lgitrt/DroneController/Assembly2.stl

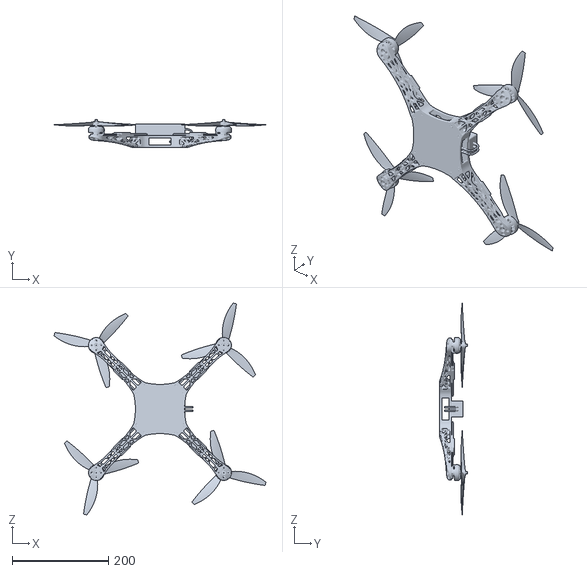
[picture p11: CAD file, 2026-10-02, last stored version]
Assembly2.stl
439.6 x 58.8 x 439.6
