lgitrt/DroneController/vector.stl

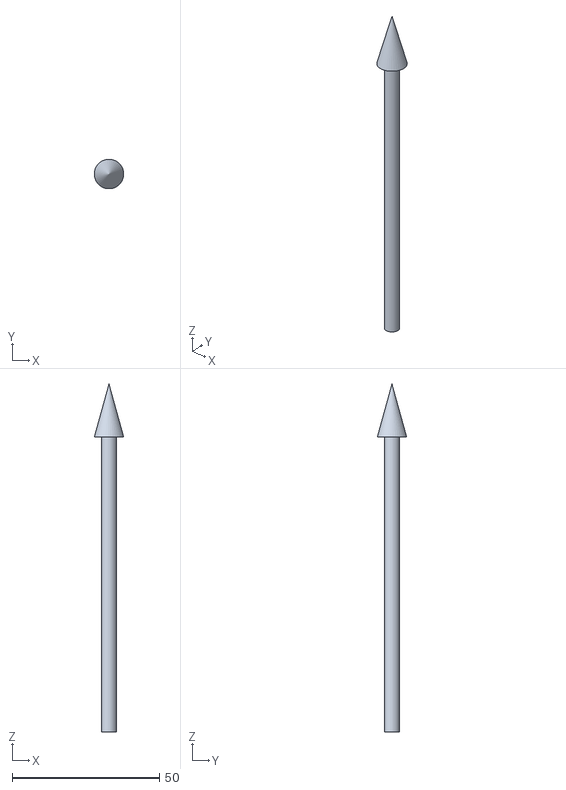
[picture p12: CAD file, 2026-10-02, last stored version]
vector.stl
9.99 x 9.98 x 118.0
