lgitrt/DroneController/simulation/results/metrics.csv

rmse3D | rmseCoordinate | rmsePerAxis_1 | rmsePerAxis_2 | rmsePerAxis_3 | rmseCircle3D | maxError3D | meanCommandDeviation | peakCommandStep | saturatedSamples | rateLimitedSamples | meanSolveTimeMs | maxSolveTimeMs | estimationPositionRMSE | estimationAttitudeRMSEDeg | scenario | controller
0.0178046399109007 | 0.0102795136453829 | 0.000950504631318332 | 0.000624533601822021 | 0.0177682779436522 | 0.00467186624388359 | 0.0752451704655104 | 4602.85762935558 | 0.0106209011376921 | 0 | 0 | 0.00267288888888889 | 0.0509 | 0 | 0 | Ideal baseline | LQR
0.00271685040925663 | 0.00156857431513226 | 0.000808077234212324 | 0.000516532399092589 | 0.00254194445464753 | 0.000884098852815674 | 0.0129169398279457 | 3961.38499079515 | 0.0259945474537169 | 0 | 0 | 12.9785901111111 | 19.1804 | 0 | 0 | Ideal baseline | MPC
0.00389352958771861 | 0.00224793035556711 | 0.00298809711484834 | 0.00222293713088047 | 0.00113551697249677 | 0.00163082225779905 | 0.0172624434986543 | 4034.92906290898 | 0.0123291770886608 | 0 | 0 | 0.0307911111111111 | 2.373 | 0 | 0 | Ideal baseline | PID
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
