lgitrt/DroneController/simulation/results/validation.csv

seed | scenario | controller | rmse3D | rmseCircle3D | rmseWindWindow | rmseRecovery | maxError3D | estimationPositionRMSE | estimationAttitudeRMSEDeg | maxTiltDeg | saturatedSamples | rateLimitedSamples
20261002 | Noisy sensors and EKF | LQR | 0.0330699491699417 | 0.0227247132153702 | 0.0244519361269129 | 0.02149828647545 | 0.117047857946727 | 0.0179100170010101 | 0.379422865232148 | 4.27293983269353 | 0 | 0
20261002 | Noisy sensors and EKF | MPC | 0.0244736984666733 | 0.0225876530354913 | 0.024825329715124 | 0.0214561852056178 | 0.04795182974722 | 0.0179049760461515 | 0.443083907621406 | 4.26426362282017 | 0 | 0
20261002 | Noisy sensors and EKF | PID | 0.0307494063689642 | 0.0283685834344498 | 0.0283064235455322 | 0.0232350668166645 | 0.0577169099464077 | 0.0179078414650569 | 0.40836027133457 | 3.65467926419492 | 0 | 0
20261002 | Wind, motor lag and sensors | LQR | 0.056268005718662 | 0.053235268309342 | 0.0795856451433738 | 0.0222374167342717 | 0.130447094556258 | 0.0178557113670422 | 0.323838967380567 | 4.58011159055663 | 0 | 0
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
