lgitrt/DroneController/Core/Src/main.c

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
/* Includes ------------------------------------------------------------------*/
#include "main.h"

/* USER CODE BEGIN Includes */
#include <stdio.h>
#include "IMU_KF.h"
#include "PID.h"
#include "mpu6050.h"

/* USER CODE END Includes */

I2C_HandleTypeDef hi2c1;

TIM_HandleTypeDef htim1;
TIM_HandleTypeDef htim2;
TIM_HandleTypeDef htim3;
TIM_HandleTypeDef htim4;
TIM_HandleTypeDef htim6;
TIM_HandleTypeDef htim8;
TIM_HandleTypeDef htim15;
TIM_HandleTypeDef htim16;
TIM_HandleTypeDef htim17;

/* USER CODE BEGIN PV */
struct est estimate;
struct est estimateCompFilter;
struct motSpeeds omegaMot;
struct motSpeeds motorPWM;
long unsigned t_main = 0;
double ts = 0.001; 	// ts in s
double phiEst = 0;
double thetaEst = 0;
double yawInt = 0;
float recRoll; float recPitch; float recYaw; float recAltitude;
float rollMin = -pi/4; float rollMax = pi/4;
float pitchMin = -pi/4; float pitchMax = pi/4;
float thrustMin = 0; float thrustMax = 80; // [N]
uint32_t recRollDuty; uint32_t recPitchDuty; uint32_t recYawDuty; uint32_t recThrustDuty;		//tim15 = pitch, tim8 = roll, tim16 = yaw, tim17 = thrust
uint32_t recRollCapt; uint32_t recPitchCapt; uint32_t recYawCapt; uint32_t recThrustCapt;
uint16_t timeTaken = 0;
uint32_t recRollDutyZero = 750; uint16_t recRollDutyMax = 209;  uint16_t recRollDutyMin = -209;
uint32_t recPitchDutyZero = 205; uint16_t recPitchDutyMax = 57; uint16_t recPitchDutyMin = -57;
uint32_t recYawDutyZero = 195; uint16_t recYawDutyMax = -56; uint16_t recYawDutyMin = 56;
uint32_t recThrustDutyZero = 147; int16_t recThrustDutyMax = 113; int16_t recThrustDutyMin = 0;
uint16_t phiPlot = 0;

float alphaAlt = 0.001; float recAltitudeOld = 0;
float alphaRoll = 0.01; float recRollOld = 0;
float alphaPitch = 0.01; float recPitchOld = 0;
float alphaYaw = 0.005; float recYawOld = 0;


int counter = 0;
/* USER CODE END PV */

void SystemClock_Config(void);
static void MX_GPIO_Init(void);
static void MX_TIM2_Init(void);
static void MX_I2C1_Init(void);
static void MX_TIM16_Init(void);
static void MX_TIM3_Init(void);
static void MX_TIM4_Init(void);
static void MX_TIM8_Init(void);
static void MX_TIM6_Init(void);
static void MX_TIM15_Init(void);
static void MX_TIM17_Init(void);
static void MX_TIM1_Init(void);
/* USER CODE BEGIN 0 */
/*#ifdef __GNUC__
#define PUTCHAR_PROTOTYPE int __io_putchar(int ch)
#else
#define PUTCHAR_PROTOTYPE int fputc(int ch, FILE *f)
#endif

PUTCHAR_PROTOTYPE
{
  HAL_UART_Transmit(&huart2, (uint8_t *)&ch, 1, HAL_MAX_DELAY);
  return ch;
}*/

// read PWM signals
void HAL_TIM_IC_CaptureCallback(TIM_HandleTypeDef *htim)
{
	// timer 8 pitch
	if (htim->Instance == htim8.Instance) {
		if (htim->Channel == HAL_TIM_ACTIVE_CHANNEL_1)  // If the interrupt is triggered by channel 1
		{
			// Read the IC value
			recPitchCapt = HAL_TIM_ReadCapturedValue(htim, TIM_CHANNEL_1);

			if (recPitchCapt)
			{
				// calculate the Duty Cycle
				recPitchDuty = (HAL_TIM_ReadCapturedValue(htim, TIM_CHANNEL_2) *100)/recPitchCapt;
			}
		}
	}
	// timer 2 roll
	else if (htim->Instance == htim2.Instance) {
		if (htim->Channel == HAL_TIM_ACTIVE_CHANNEL_1)  // If the interrupt is triggered by channel 1
		{
			// Read the IC value
			recRollCapt = HAL_TIM_ReadCapturedValue(htim, TIM_CHANNEL_1);

			if (recRollCapt)
			{
				// calculate the Duty Cycle
				recRollDuty = (HAL_TIM_ReadCapturedValue(htim, TIM_CHANNEL_2) *10000)/recRollCapt;
			}
		}
	}
	// timer 3 yaw
	else if (htim->Instance == htim3.Instance) {
		if (htim->Channel == HAL_TIM_ACTIVE_CHANNEL_1)  // If the interrupt is triggered by channel 1
		{
			// Read the IC value
			recYawCapt = HAL_TIM_ReadCapturedValue(htim, TIM_CHANNEL_1);

			if (recYawCapt)
			{
				// calculate the Duty Cycle
				recYawDuty = (HAL_TIM_ReadCapturedValue(htim, TIM_CHANNEL_2) *100)/recYawCapt;
			}
		}
	}
	// timer 4 thrust
	else if (htim->Instance == htim4.Instance) {
		if (htim->Channel == HAL_TIM_ACTIVE_CHANNEL_1)  // If the interrupt is triggered by channel 1
		{
			// Read the IC value
			recThrustCapt = HAL_TIM_ReadCapturedValue(htim, TIM_CHANNEL_1);

			if (recThrustCapt)
			{
				// calculate the Duty Cycle
				recThrustDuty = (HAL_TIM_ReadCapturedValue(htim, TIM_CHANNEL_2) *100)/recThrustCapt;
			}
		}
	}
}

/* USER CODE END 0 */

/**
  * @brief  The application entry point.
  * @retval int
  */
int main(void)
{

  /* MCU Configuration--------------------------------------------------------*/

  /* Reset of all peripherals, Initializes the Flash interface and the Systick. */
  HAL_Init();

  /* Configure the system clock */
  SystemClock_Config();

  /* Initialize all configured peripherals */
  MX_GPIO_Init();
  MX_TIM2_Init();
  MX_I2C1_Init();
  MX_TIM16_Init();
  MX_TIM3_Init();
  MX_TIM4_Init();
  MX_TIM8_Init();
  MX_TIM6_Init();
  MX_TIM15_Init();
  MX_TIM17_Init();
  MX_TIM1_Init();
  /* USER CODE BEGIN 2 */
  //MPU6050_Init();
  HAL_TIM_Base_Start(&htim6);
  //HAL_TIM_Base_Start(&htim2);

  // pwm out timers
  HAL_TIM_PWM_Start(&htim1, TIM_CHANNEL_1);		//PA8
  HAL_TIM_PWM_Start(&htim15, TIM_CHANNEL_1);	//PA2
  HAL_TIM_PWM_Start(&htim16, TIM_CHANNEL_1);	//PA12
  HAL_TIM_PWM_Start(&htim17, TIM_CHANNEL_1);	//PA7

  //roll timer pwm in -> rec ch 8
  HAL_TIM_IC_Start_IT(&htim2, TIM_CHANNEL_1);   // main channel
  HAL_TIM_IC_Start(&htim2, TIM_CHANNEL_2);

  //pitch timer pwm in -> rec ch 2
  HAL_TIM_IC_Start_IT(&htim8, TIM_CHANNEL_1);   // main channel
  HAL_TIM_IC_Start(&htim8, TIM_CHANNEL_2);   // indirect channel

  //yaw timer pwm in -> rec ch 4
  HAL_TIM_IC_Start_IT(&htim3, TIM_CHANNEL_1);   // main channel
  HAL_TIM_IC_Start(&htim3, TIM_CHANNEL_2);   // indirect channel

  //thrust timer pwm in -> rec ch 3
  HAL_TIM_IC_Start_IT(&htim4, TIM_CHANNEL_1);   // main channel
  HAL_TIM_IC_Start(&htim4, TIM_CHANNEL_2);   // indirect channel

  MPU6050_Initialization();

  calibrateGyro(0.1, 0.1);	// calibrate gyro for 2 seconds, wait 1 second to let sensor settle
  calibrateMotors();




  /* USER CODE END 2 */

  /* Infinite loop */
  /* USER CODE BEGIN WHILE */
  while (1)
  {
    /* USER CODE END WHILE */

    /* USER CODE BEGIN 3 */

	/*		Start 1 ms loop		*/
	__HAL_TIM_SET_COUNTER(&htim6,0);	// set timer counter to 0

	// read receiver (6 us)
	recRoll = roundf(((float)recRollDuty-(float)recRollDutyZero)*rollMax/recRollDutyMax * 100) / 100;
	recRoll = alphaRoll*recRoll + (1-alphaRoll)*recRollOld;	//digital lowpass receiver
	recRollOld = recRoll;
	recPitch = roundf(((float)recPitchDuty-(float)recPitchDutyZero)*pitchMax/recPitchDutyMax * 100) / 100;
	recPitch = alphaPitch*recPitch + (1-alphaPitch)*recPitchOld;	//digital lowpass receiver
	recPitchOld = recPitch;
	recYaw = roundf((((float)recYawDuty-(float)recYawDutyZero)) * 100) / 100;
	recYaw = alphaYaw*recYaw + (1-alphaYaw)*recYawOld;	//digital lowpass receiver
	recYawOld = recYaw;
	recAltitude = roundf(((float)recThrustDuty - (float)recThrustDutyZero)*thrustMax/recThrustDutyMax * 100) / 100;
	recAltitude = alphaAlt*recAltitude + (1-alphaAlt)*recAltitudeOld;	//digital lowpass receiver
	recAltitudeOld = recAltitude;
	recRoll = 0;
	recPitch = 0;
	recYaw = 0;
/*
	if (recRoll<0.01) {recRoll =0;}
	if (recPitch<0.01) {recPitch =0;}
	if (recAltitude<3) {recAltitude =0;}

*/
	// Read IMU Sensors
	MPU6050_ProcessData(&MPU6050);
	// ->> reading the sensor takes 425 us -> 575 us for control and KF

	// Call KF
	//estimate = callKF(MPU6050.acc_x, MPU6050.acc_y, MPU6050.acc_z, MPU6050.gyro_x, MPU6050.gyro_x, MPU6050.gyro_x, ts);		// ekf takes 65 us
	estimateCompFilter = callCompFilter(MPU6050.acc_x, MPU6050.acc_y, MPU6050.acc_z, MPU6050.gyro_x, MPU6050.gyro_y, MPU6050.gyro_z, ts);
	estimate.phi = estimateCompFilter.phi;
	estimate.theta = estimateCompFilter.theta;
	estimate.psi = 0;
	phiPlot = (uint16_t)(estimate.phi*180/pi);

	// Call Ctr
	omegaMot = callPID(estimate.phi, estimate.theta, estimate.psi, recRoll, recAltitude, recPitch, recYaw, ts);

	// convert motor speed to PWM Dutycycle
	motorPWM.w2 = (uint16_t)((omegaMot.w1 - 0) * (5000 - 2500) / (w_max - 0) + 2500);	// motor right
	motorPWM.w3 = (uint16_t)((omegaMot.w2 - 0) * (5000 - 2500) / (w_max - 0) + 2500);	// motor back
	motorPWM.w4 = (uint16_t)((omegaMot.w3 - 0) * (5000 - 2500) / (w_max - 0) + 2500);	// motor left
	motorPWM.w1 = (uint16_t)((omegaMot.w4 - 0) * (5000 - 2500) / (w_max - 0) + 2500);	// motor front
	//motorPWM.w1 = (uint16_t)((recAltitude - 0) * (100 - 50) / (thrustMax - 0) + 50);	// motor right
	if (motorPWM.w1 < 2800) {motorPWM.w1 = 2800;}
	if (recAltitude < 4) {motorPWM.w1 = 2500;};
	if (motorPWM.w1 > 5000) {motorPWM.w1 = 5000;}
	if (motorPWM.w2 < 2800) {motorPWM.w2 = 2800;}
	if (recAltitude < 4) {motorPWM.w2 = 2500;};
	if (motorPWM.w2 > 5000) {motorPWM.w2 = 5000;}
	if (motorPWM.w3 < 2800) {motorPWM.w3 = 2800;}
	if (recAltitude < 4) {motorPWM.w3 = 2500;};
	if (motorPWM.w3 > 5000) {motorPWM.w3 = 5000;}
	if (motorPWM.w4 < 2800) {motorPWM.w4 = 2800;}
	if (recAltitude < 4) {motorPWM.w4 = 2500;};
	if (motorPWM.w4 > 5000) {motorPWM.w4 = 5000;}



	//printf("%f\t%f\t%f\t%f\n", omegaMot.w1, omegaMot.w2, omegaMot.w3, omegaMot.w4);

	/*
	float motorSpeed = 0;
	motorSpeed = (uint16_t)((estimate.phi - 0) * (100 - 50) / (pi/2 - 0) + 50);
	if (motorSpeed < 50) {motorSpeed = 50;}
	if (motorSpeed > 100) {motorSpeed = 100;}
	TIM1->CCR1 = motorSpeed;*/
	TIM1->CCR1 = motorPWM.w1;		// motor w1
	TIM16->CCR1 = motorPWM.w2;	//motor w2
	TIM15->CCR1 = motorPWM.w3; //motor w3
	TIM17->CCR1 = motorPWM.w4;	//motor w4

	//printf("%f\t%f\t%f\t%f\n", estimate.phi, estimate.theta, estimateCompFilter.phi, estimateCompFilter.theta);

	//printf("time: %lu\n", __HAL_TIM_GET_COUNTER(&htim16));


	// additional delay to get to 1ms loop time
	while (__HAL_TIM_GET_COUNTER(&htim6) < ts*1000000) {}
	timeTaken = __HAL_TIM_GET_COUNTER(&htim6);
	//printf("Phi: %f\tTheta: %f\tTot: %lu\n", estimate.phi, estimate.theta, __HAL_TIM_GET_COUNTER(&htim16));

	/*		Finish 1 ms loop		*/

  }
  /* USER CODE END 3 */
}

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
/* USER CODE BEGIN 4 */

// motor calibration
void calibrateMotors(void) {
	TIM1->CCR1 = 5000;  // Set the maximum pulse (2ms)
	TIM15->CCR1 = 5000;  // Set the maximum pulse (2ms)
	TIM16->CCR1 = 5000;  // Set the maximum pulse (2ms)
	TIM17->CCR1 = 5000;  // Set the maximum pulse (2ms)
	HAL_Delay (2000);  // wait for 1 beep
	TIM1->CCR1 = 2500;   // Set the minimum Pulse (1ms)
	TIM15->CCR1 = 2500;   // Set the minimum Pulse (1ms)
	TIM16->CCR1 = 2500;   // Set the minimum Pulse (1ms)
	TIM17->CCR1 = 2500;   // Set the minimum Pulse (1ms)
	HAL_Delay (1000);  // wait for 2 beeps
	TIM1->CCR1 = 0;    // reset to 0, so it can be controlled via ADC
	TIM15->CCR1 = 0;    // reset to 0, so it can be controlled via ADC
	TIM16->CCR1 = 0;    // reset to 0, so it can be controlled via ADC
	TIM17->CCR1 = 0;    // reset to 0, so it can be controlled via ADC
}


// gyro calibration
void calibrateGyro(uint32_t calTime, uint32_t pauseTime) {
	// calibrates gyro by computing its offsets for a duration of calTime in s

	// gyro calibration values
	double gyrOffsX = 0;
	double gyrOffsY = 0;
	double gyrOffsZ = 0;

	uint16_t count = 0;
	while (count < pauseTime*1000) {
			// Read gyr
			MPU6050_ProcessData(&MPU6050);
			count++;
			HAL_Delay(1);
		}

	count = 0;
	while (count < calTime*1000) {
		// Read gyr
		MPU6050_ProcessData(&MPU6050);
		gyrOffsX += MPU6050.acc_x;
		gyrOffsY += MPU6050.acc_y;
		gyrOffsZ += MPU6050.acc_z;
		count++;
		//printf("Gyro Offsets xyz: %f\t%f\t%f\t", gyrOffsX, gyrOffsY, gyrOffsZ);
		//printf("count: %d\t calCount: %d\n", count, calTime*10);
		HAL_Delay(1);
	}
	gyrOffsX = gyrOffsX/count;
	gyrOffsX = -0.026010986328124999;
	gyrOffsY = gyrOffsY/count;
	gyrOffsY = 0.048194531249999999;
	gyrOffsZ = gyrOffsZ/count;
	gyrOffsZ = 1.0498394287109376;
	setGyrOffset(gyrOffsX,gyrOffsY,gyrOffsZ);
}

// map function
float map(float x, float in_min, float in_max, float out_min, float out_max) {
  return (x - in_min) * (out_max - out_min) / (in_max - in_min) + out_min;
}

// convert dutycycle to angle and force
void convDutyToAng(float recRollIn, float recPitchIn, float recYawIn, float recAltitudeIn) {
	/*if (recRollIn >= 0) {
		 // map(recRollIn, 0, recRollDutyMax, 0, rollMax);
	}
	recRoll = recRollIn;*/

}






/* USER CODE END 4 */
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
