lgitrt/DroneController/DroneController.ioc

Mcu.UserName=STM32G431KBTx
PA0.Signal=S_TIM2_CH1
PA11.Signal=S_TIM4_CH1
PA12.Signal=S_TIM16_CH1
PA13.GPIO_Label=T_SWDIO
PA13.Signal=SYS_JTMS-SWDIO
PA14.GPIO_Label=T_SWCLK
PA14.Signal=SYS_JTCK-SWCLK
PA15.Signal=I2C1_SCL
PA2.Signal=S_TIM15_CH1
PA6.Signal=S_TIM3_CH1
PA7.Signal=S_TIM17_CH1
PA8.Signal=S_TIM1_CH1
PB3.GPIO_Label=T_SWO
PB3.Signal=SYS_JTDO-SWO
PB6.Signal=S_TIM8_CH1
PB7.Signal=I2C1_SDA
PF0-OSC_IN.Signal=RCC_OSC_IN
PF1-OSC_OUT.Signal=RCC_OSC_OUT
