lgitrt/DroneController/(commit log)

2026-10-02 Add STM32G431 flight controller firmware, tests, and project cleanup
    - Move the STM32CubeIDE project (IMU-fused attitude estimation, PID
    control, quadrotor motor mixing) from the parent workspace folder into
    this repo so the repo root matches the project root, consistent with
    tinyVario.
    - Rename the STM32CubeIDE project from the internal dev name KF_timed to
    DroneController across .project/.cproject/.ioc/.launch so IDE metadata
    matches the repo name.
    - Rename PID.h's single-letter l/d macros to ARM_LENGTH/DRAG_COEFF: they
    collided with internal identifiers in host libm, breaking standalone
    host compiles of PID.c.
    - Add a host-side unit test suite (tests/) for the HAL-free IMU_K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
    [DroneController.ioc, IMU_KF.c, IMU_KF.h, PID.c, PID.h, main.c, main.h, mpu6050.c]
2026-10-02 Add project images to README
    Add a CAD assembly render, a physical bench-test photo, and the
    electronics schematic/PCB for the sensor carrier board, embedded in
    README.md.
2026-10-02 Add LQR controller comparison with Aggressive vs Conservative tuning
    - Implement fast-converging Aggressive LQR (0.5 cm RMSE on circle tracking)
    - Implement energy-efficient Conservative LQR (2.7 cm RMSE, lower motor duty)
    - Add clean MATLAB module structure: parameters, dynamics, control, simulation
    * parameters.m - physical constants and design specifications
    * quadrotorLinearModel.m - linearization at hover
    * designLQR.m - LQR with selectable tuning strategies
    * circleTrajectory.m - smooth reference path with feedforward attitude
    * simulateClosedLoop.m - nonlinear closed-loop simulation (RK4)
    * plotComparison.m - performance visualization (5 figures)
    - Verify full controllabi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
2026-10-02 Revert misplaced simulation merge
    Restore the original firmware tree before adding the simulation in a dedicated directory.
    [Assembly2.stl, vector.stl]
2026-10-02 Implement constrained MPC and validated LQR trajectory comparison
    Correct the nonlinear yaw model and share physical parameters. Compare matched-cost discrete LQR and preview MPC under ideal and wind/motor-lag conditions, with shared actuator limits and explicit solver failure reporting. Add nine regression tests, fourteen readable comparison figures, CSV metrics, and documented assumptions.
    [metrics.csv]
2026-10-02 Add noisy aided IMU, navigation EKF and PID controller comparison
    Simulate 200 Hz accelerometer/gyro with calibrated residual bias and random-walk drift, 10 Hz RTK-GNSS and 20 Hz magnetic aiding. Feed a fifteen-state navigation EKF estimate to LQR, MPC and cascaded PID with shared limits and standard plus-frame mixing. Add reproducible noise, anti-windup state logging, sensor/estimator regression tests, twenty-five readable plots and controller/estimator state-space equations.
    [metrics.csv]
2026-10-02 Audit controller results and streamline simulation documentation
    [metrics.csv, validation.csv]
2026-10-06 Fix complementary roll gyro mapping and clarify control scope
    Add isolated gyro-axis regressions and distinguish STM32 complementary/PD prototype from MATLAB navigation and control studies.
    [IMU_KF.c, test_imu_kf.c]
